HimC29/hc-soundbox/schematics/HC_SoundBox.pdf

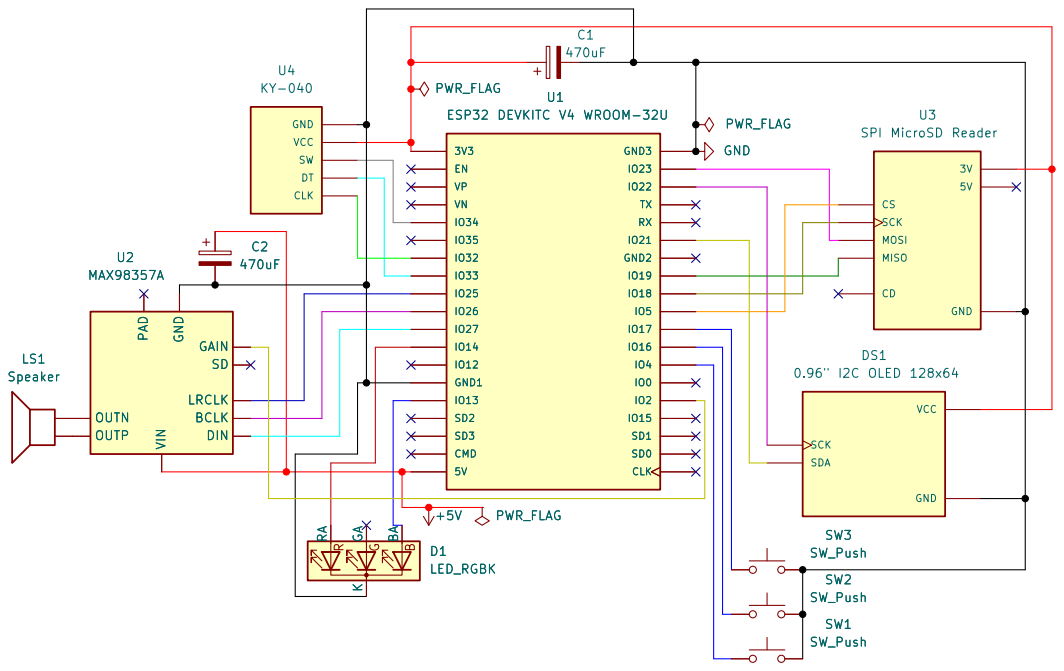
[picture p1: page 1]

Size: A4 | Rev:
