HimC29/hc-soundbox/(commit log)

2026-04-08 Version 1.0.0 - A standalone MP3/WAV player with OLED display, rotary encoder navigation, and real-time volume control playing from a microSD — all powered by an ESP32.
    [HC_SoundBox.kicad_sch]
2026-06-17 fix: cleanup code and make auto advance work properly
    [helpers.cpp, helpers.h, main.cpp, sdAudio.cpp, sdGlobals.cpp, sdGlobals.h, sdMenu.cpp]
2026-06-18 feat: add settings menu to change settings setting options: OLED brightness, RGB LED brightness, volume step interval, sd start volume, bt start volume, song sort there is also a option to restore de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
2026-06-20 fix: make total duration of audio accurate for 48kHz mp3s
    [helpers.cpp, helpers.h, sdAudio.cpp]
2026-06-20 fix: fixed issue where some mp3s cannot be paused properly, as it acts like setting the gain to zero instead of actually pausing
    [sdAudio.cpp, sdGlobals.cpp, sdGlobals.h, sdMenu.cpp]
2026-06-20 fix: correctly calculate MP3 duration with ID3v2 tags
    [sdAudio.cpp]
2026-06-21 fix: stop program from crashing when playing audio in the background and then choosing bluetooth in the system menu
    [main.cpp]
2026-06-22 perf: optimize ram and flash usage by avoiding duplicate dir copies and using references
    [helpers.cpp, helpers.h, sdAudio.cpp, sdAudio.h]
2026-07-04 refactor: replace magic numbers with variables for i2s pins
    [main.cpp]
