HimC29/hc-soundbox/(notices)

Notices in the files:
README.md:
License: GPL v3
